Secure-Embedded-Systems/capri1_ets/CAPRI1_verifyPIN0.pdf

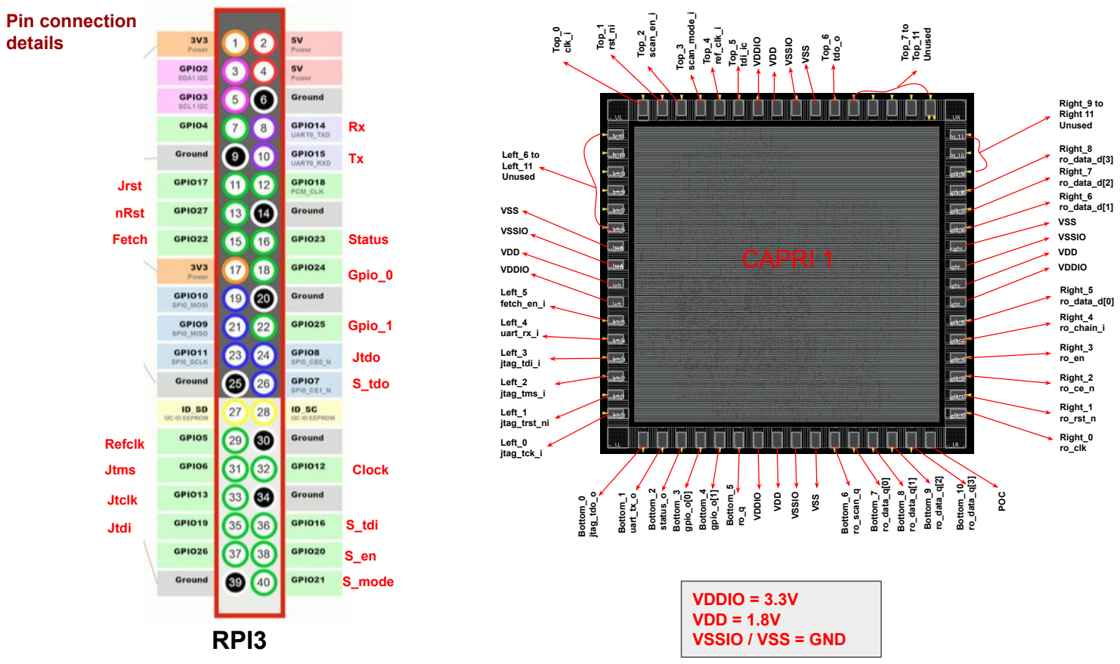
[picture p9: page 1]
RPI3; Bottom_10; ro_data_q[3]; VSS; VSSIO; VDD; VDDIO; Bottom_5; Bottom_2; status_o; Bottom_3; gpio_o[0]; Bottom_4; gpio_o[1]; Bottom_1; uart_tx_o; Bottom_0; jtag_tdo_o; POC; Bottom_8; Bottom_9; ro_data_q[2]; Bottom_6; Bottom_7; ro_data_q[0]; ro_data_q[1]; ro_scan_q; Left_0 jtag_tck_i; Left_1 jtag_trst_ni; Left_2 jtag_tms_i; Left_3 jtag_tdi_i; Left_4 uart_rx_i; Left_5 fetch_en_i; Left_6 to Left_11 Unused; Right_0 ro_clk; Right_1 ro_rst_n; Right_2 ro_ce_n; Right_3 ro_en; Right_4 ro_chain_i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

Refclk

Clock

Jtclk

S_tdi

Jtdi

VDDIO = 3.3V
VDD = 1.8V
VSSIO / VSS = GND

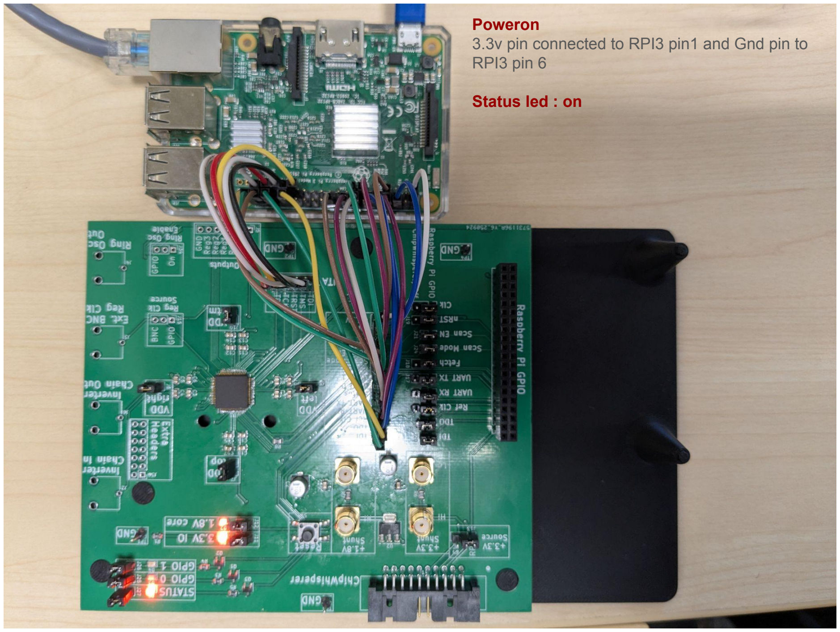
[picture p10: page 2]

Poweron
3.3v pin connected to RPI3 pin1 and Gnd pin to RPI3 pin 6

Status led : on

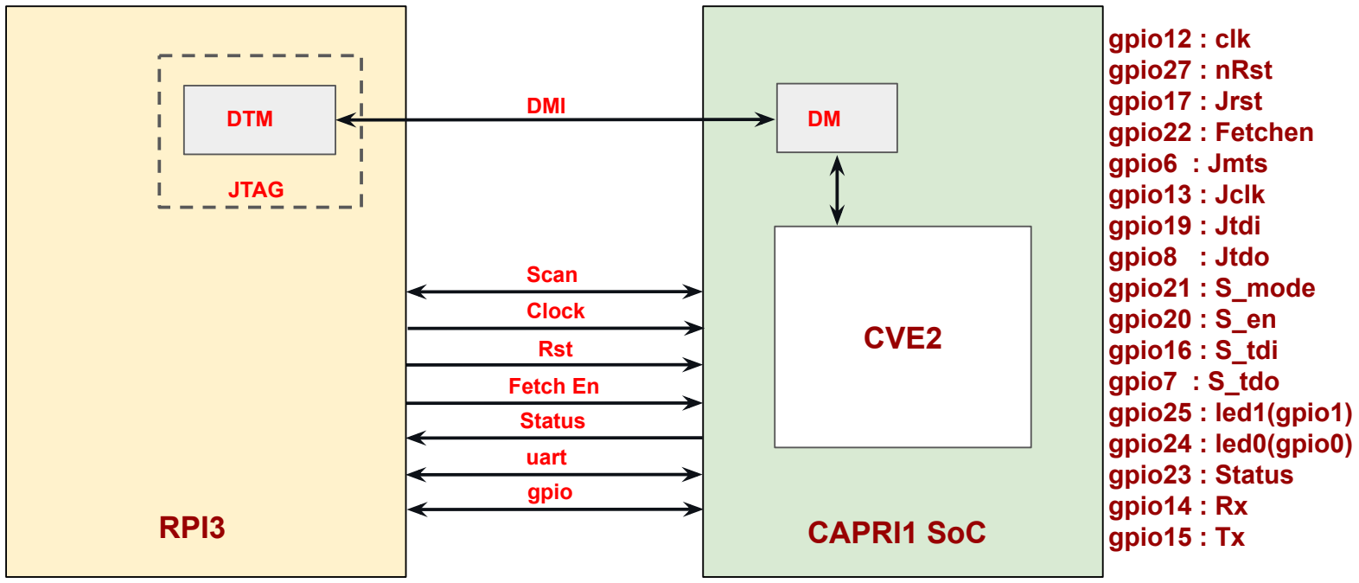
[picture p11: figure]
DTM; DM DMI; JTAG; CVE2; RPI3; CAPRI1 SoC; Scan; Clock; Rst; Fetch En; Status; uart; gpio; gpio12 : clk gpio27 : nRst gpio17 : Jrst gpio22 : Fetchen gpio6 : Jmts gpio13 : Jclk gpio19 : Jtdi gpio8 : Jtdo gpio21 : S_mode gpio20 : S_en gpio16 : S_tdi gpio7 : S_tdo gpio25 : led1(gpio1) gpio24 : led0(gpio0) gpio23 : Status gpio14 : Rx gpio15 : Tx

# Configuration 1. ./prep_pins.sh

2. openocd -f rpi3_gpio.cfg -f capri1_target.cfg; init; reset halt;

# 3. reset.tcl(when DM halt hart fails to responded) Capture : map and group 4. scan_chain_capture_10cc.py 5. map_and_group_script.py

pschaumont@raspberrypi:~/capri1/scripts/9oct/test/v1 $ ./prep_pins.sh [prep] ensure pigpiod is running
GPIO 12: level=1 fsel=4 alt=0 func=PWM0
[prep] status:
GPIO17: GPIO 17: level=1 fsel=1 func=OUTPUT GPIO27: GPIO 27: level=1 fsel=1 func=OUTPUT GPIO12: GPIO 12: level=1 fsel=4 alt=0 func=PWM0 GPIO22: GPIO 22: level=0 fsel=1 func=OUTPUT GPIO6 : GPIO 6: level=1 fsel=1 func=OUTPUT GPIO13: GPIO 13: level=0 fsel=1 func=OUTPUT GPIO19: GPIO 19: level=0 fsel=1 func=OUTPUT GPIO8 : GPIO 8: level=0 fsel=0 func=INPUT GPIO21: GPIO 21: level=0 fsel=1 func=OUTPUT GPIO20: GPIO 20: level=0 fsel=1 func=OUTPUT GPIO16: GPIO 16: level=0 fsel=1 func=OUTPUT GPIO7 : GPIO 7: level=0 fsel=0 func=INPUT GPIO25: GPIO 25: level=0 fsel=0 func=INPUT GPIO24: GPIO 24: level=0 fsel=0 func=INPUT GPIO23: GPIO 23: level=1 fsel=0 func=INPUT
GPIO14: GPIO 14: level=0 fsel=1 func=OUTPUT
GPIO15: GPIO 15: level=1 fsel=0 func=INPUT
[prep] Clock is now on GPIO12 (PWM0). Wire CAPRI1 clk_i to GPIO12.

## ./prep_pins.sh

# Configuration : GPIO pins on RPI3

pschaumont@raspberrypi:~/capri1/scripts/9oct/test/v1 $ openocd -f rpi3_gpio.cfg -f capri1_target.cfg Open On-Chip Debugger 0.12.0
Licensed under GNU GPL v2
For bug reports, read
http://openocd.org/doc/doxygen/bugs.html adapter speed: 100 kHz

Warn : Transport "jtag" was already selected
0
Info : Listening on port 6666 for tcl connections Info : Listening on port 4444 for telnet connections
Info : BCM2835 GPIO JTAG/SWD bitbang driver
Info : clock speed 100 kHz
Info : JTAG tap: capri1.cpu tap/device found: 0x0c0c5db3 (mfg: 0x6d9 (PULP Platform), part: 0xc0c5, ver: 0x0) Info : datacount=2 progbufsize=8
Info : Examined RISC-V core; found 1 harts
Info : hart 0: XLEN=32, misa=0x40100104
Info : starting gdb server for capri1.cpu on 3333 Info : Listening on port 3333 for gdb connections

## openocd -f rpi3_gpio.cfg -f capri1_target.cfg

# Configuration : openocd

init
riscv dmi_write 0x10 0x00000001 | ;# dmactive=1
riscv dmi_write 0x38 0x20040C07 | ;# SBA: 32-bit, autoinc, read-on-data
riscv dmi_write 0x37 0x00000000
riscv dmi_write 0x39 0x03000004 | ;# FETCHEN
riscv dmi_write 0x3C 0x00000001 | ;# FETCHEN=1
riscv dmi_write 0x10 0x04000003 | ;# setresethaltreq|ndmreset|dmactive
sleep 20
riscv dmi_write 0x10 0x04000001 ;# release reset (resethaltreq still set) sleep 20
riscv dmi_write 0x10 0x02000001 ;# clrresethaltreq
riscv dmi_read 0x11

# Reset

### reset.tcl (when DM halt hart fails to responded)

mww 0x10000000 0x0 256
mdw 0x10000000 256

halt
load_image /home/pschaumont/capri1/scripts/9oct/test/v1/verifyPIN_0/verifyPIN_0_opt.bin 0x10000000 bin
shutdown

# Load_image

## scan_chain_capture_10cc.py (capture 10cc scan chain values) map_and_group_script.py (map and group bits)

# Capture : scan chain values

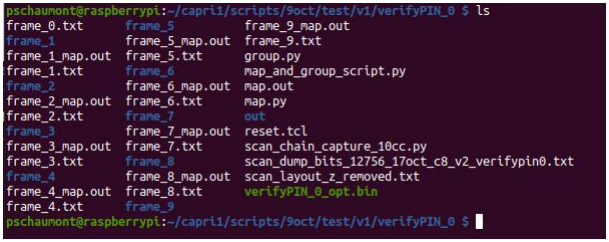
[picture p12: figure]

## verifyPIN_0

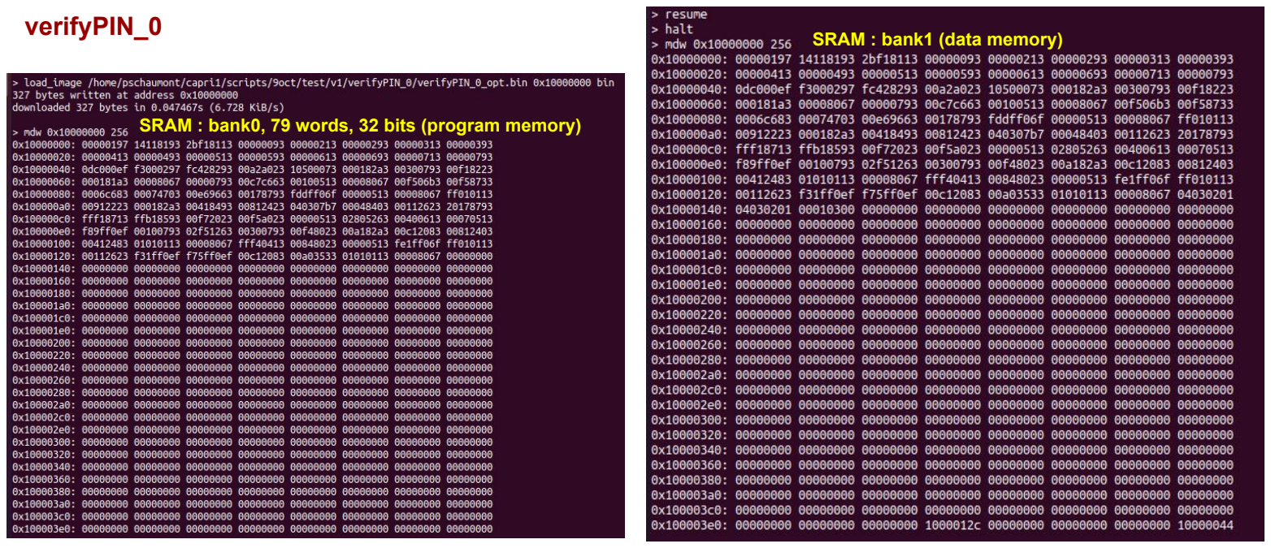
[picture p13: page 9]

SRAM : bank0, 79 words, 32 bits (program memory)

SRAM : bank1 (data memory)

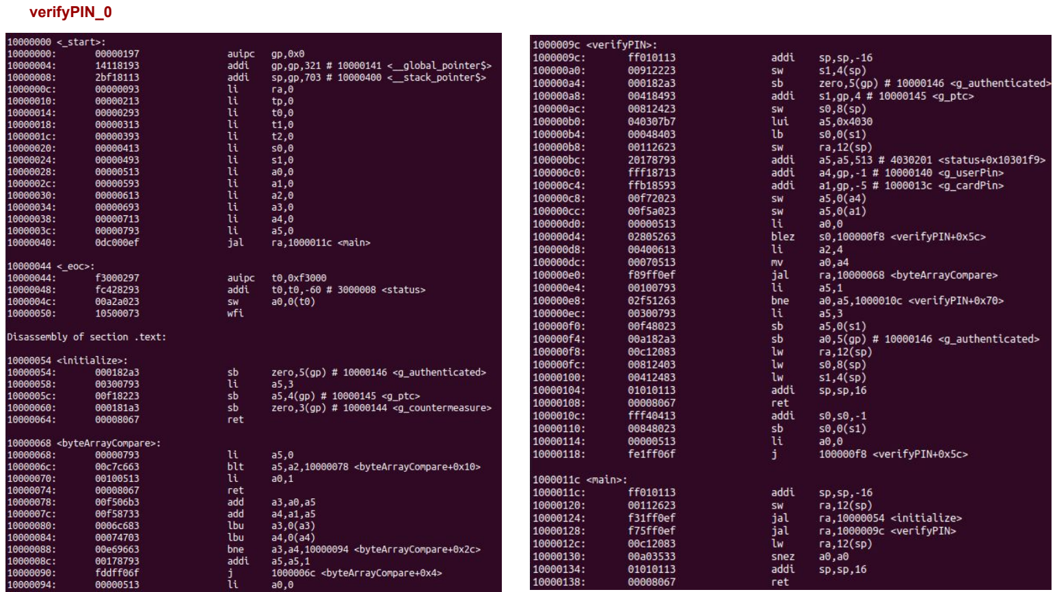
[picture p14: page 10]

verifyPIN_0
