Secure-Embedded-Systems/capri1_ets/rtl/riscv-dbg/tb/jtag_test_simple.sv

// Copyright 2020 ETH Zurich and University of Bologna.
// Solderpad Hardware License, Version 0.51, see LICENSE for details.
// SPDX-License-Identifier: SHL-0.51

// Author: Andreas Traber <atraber@iis.ee.ethz.ch>
// Author: Florian Zaruba <zarubaf@iis.ee.ethz.ch>
// Author: Fabian Schuiki <fschuiki@iis.ee.ethz.ch>
// Author: Thomas Benz <tbenz@iis.ee.ethz.ch>
timeunit 1ns;
timeprecision 1ps;


module jtag_driver_simple #(
  parameter int IrLength = 0,
  parameter IDCODE       = 'h1,
  parameter time TA      = 0ns,  // stimuli application time
  parameter time TT      = 0ns   // stimuli test time
) (
  input  logic jtag_tck_i,
  output logic jtag_trst_no,
  output logic jtag_tms_o,
  output logic jtag_tdi_o,
  input  logic jtag_tdo_i
);

  localparam DMIWidth = $bits(dm::dmi_req_t);

  // last IR register select
  logic [IrLength-1:0] ir_select = 'h1;

  task reset_master;
    #TA;
    jtag_tms_o   = 1;
    jtag_tdi_o   = 0;
    jtag_trst_no = 0;
    repeat (2) clock();
    #TA;
    jtag_trst_no  = 1;
    ir_select = 'h1;
    clock();
  endtask

  task soft_reset();
    #TA;
    jtag_tms_o = 1;
    jtag_tdi_o = 0;
    repeat (6) clock();
    #TA;
    jtag_tms_o = 0;
    clock();
    // After softreset the IR should be reset to IDCODE so we have to mirror
    // this in our internal state.
    ir_select = 'h1;
  endtask

  // Set IR, but only if it needs to be set.
  task set_ir(input logic [IrLength-1:0] opcode);
    logic opcode_unpacked [IrLength];
    // check whether IR is already set to the right value
    if (ir_select == opcode) return;
    // {<<{opcode_unpacked}} = opcode;
    for (int i = 0; i < IrLength; i++) begin
        opcode_unpacked[i] = opcode[i];
    end
    write_tms(1); // select DR scan
    write_tms(1); // select IR scan
    write_tms(0); // capture IR
    write_tms(0); // shift IR
    write_bits_opcode(opcode_unpacked, 1);
    write_tms(1); // update IR
    write_tms(0); // run test idle
    ir_select = opcode;
  endtask
  // Go from `run_test_idle` to `shift_dr`
  task shift_dr();
    write_tms(1); // select DR scan
    write_tms(0); // capture DR
    write_tms(0); // shift DR
  endtask

  // Go to `run_test_idle`
  task update_dr(bit exit_1_dr);
    // depending on the state `exit_1_dr` is already reached when shifting data (`tms_on_last`).
    if (exit_1_dr) write_tms(1); // exi 1 DR
    write_tms(1); // update DR
    write_tms(0); // run test idle
  endtask

  task write_bits_opcode(input logic wdata [IrLength], input logic tms_last);
    for (int i = 0; i < IrLength; i++) begin
      #TA;
      jtag_tdi_o = wdata[i];
      if (i == (IrLength - 1)) jtag_tms_o = tms_last;
      clock();
    end
  endtask

  task write_bits_32(input logic wdata [32], input logic tms_last);
    for (int i = 0; i < 32; i++) begin
      #TA;
      jtag_tdi_o = wdata[i];
      if (i == 31) jtag_tms_o = tms_last;
      clock();
    end
  endtask

  task write_bits_dmi(input logic wdata [DMIWidth], input logic tms_last);
    for (int i = 0; i < DMIWidth; i++) begin
      #TA;
      jtag_tdi_o = wdata[i];
      if (i == (DMIWidth - 1)) jtag_tms_o = tms_last;
      clock();
    end
  endtask

  // Assumes JTAG FSM is already in shift DR state
  task readwrite_bits_32(output logic rdata [32], input logic wdata [32], input logic tms_last);
    for (int i = 0; i < 32; i++) begin
      #TA;
      jtag_tdi_o = wdata[i];
      if (i == 31) jtag_tms_o = tms_last; // tms_last ? exit1 DR : shift DR
      cycle_start();
      rdata[i] = jtag_tdo_i;
      cycle_end();
    end
  endtask

  // Assumes JTAG FSM is already in shift DR state
  task readwrite_bits_dmi(output logic rdata [DMIWidth], input logic wdata [DMIWidth], input logic tms_last);
    for (int i = 0; i < DMIWidth; i++) begin
      #TA;
      jtag_tdi_o = wdata[i];
      if (i == (DMIWidth - 1)) jtag_tms_o = tms_last; // tms_last ? exit1 DR : shift DR
      cycle_start();
      rdata[i] = jtag_tdo_i;
      cycle_end();
    end
  endtask

  task wait_idle(int cycles);
    repeat(cycles) clock();
  endtask

  task write_tms(input logic tms_val);
    #TA;
    jtag_tms_o = tms_val;
    cycle_end();
  endtask

  task clock();
    cycle_start(); cycle_end();
  endtask

  task cycle_start;
    #(TT - TA);
  endtask

  task cycle_end;
    @(posedge jtag_tck_i);
  endtask
endmodule


// abstracts the debug module
module riscv_dbg_simple #(
  parameter int IrLength = 5,
  parameter IDCODE    = 'h1,
  parameter DTMCSR    = 'h10,
  parameter DMIACCESS = 'h11,
  parameter time TA = 0ns, // stimuli application time
  parameter time TT = 0ns  // stimuli test time
) (
  input  logic jtag_tck_i,
  output logic jtag_trst_no,
  output logic jtag_tms_o,
  output logic jtag_tdi_o,
  input  logic jtag_tdo_i
);

  localparam DMIWidth = $bits(dm::dmi_req_t);

  jtag_driver_simple #(
    .IrLength ( IrLength ),
    .TA       ( TA       ),
    .TT       ( TT       )
  ) jtag (
    .jtag_tck_i,
    .jtag_trst_no,
    .jtag_tms_o,
    .jtag_tdi_o,
    .jtag_tdo_i
  );

  task reset_master();
    jtag.reset_master();
    jtag.soft_reset();
  endtask

  task wait_idle(int cycles);
    jtag.wait_idle(cycles);
  endtask

  task get_idcode(output logic [31:0] idcode);
    logic read_data [32], write_data [32];
    write_data = '{default: 1'b0};
    jtag.set_ir(IDCODE);
    jtag.shift_dr();
    jtag.readwrite_bits_32(read_data, write_data, 1'b0);
    jtag.update_dr(1'b1);
    // idcode = {<<{read_data}};
    for (int i = 0; i < 32; i++) begin
        idcode[i] = read_data[i];
    end
  endtask

  task write_dtmcs(input logic [31:0] data);
    logic write_data [32];
    logic [31:0] write_data_packed;
    write_data_packed = {data};
    // {<<{write_data}} = write_data_packed;
    for (int i = 0; i < 32; i++) begin
        write_data[i] = write_data_packed[i];
    end
    jtag.set_ir(DTMCSR);
    jtag.shift_dr();
    jtag.write_bits_32(write_data, 1'b1);
    jtag.update_dr(1'b0);
  endtask

  task read_dtmcs(output dm::dtmcs_t data, input int wait_cycles = 10);
    logic read_data [32], write_data [32];
    jtag.set_ir(DTMCSR);
    jtag.shift_dr();
    // shift out read data
    // {<<{write_data}} = 32'b0;
    for (int i = 0; i < 32; i++) begin
        write_data[i] = '0;
    end
    jtag.readwrite_bits_32(read_data, write_data, 1'b1);
    jtag.update_dr(1'b0);
    // data = dm::dtmcs_t'({<<{read_data}});
    for (int i = 0; i < 32; i++) begin
        data[i] = dm::dtmcs_t'(read_data[i]);
    end
  endtask

  task reset_dmi();
    logic [31:0] dmireset;
    dmireset = 1 << 16;
    write_dtmcs(dmireset);
  endtask

  task write_dmi(input dm::dm_csr_e address, input logic [31:0] data);
    logic write_data [DMIWidth];
    logic [DMIWidth-1:0] write_data_packed;
    write_data_packed = {address, data, dm::DTM_WRITE};
    // {<<{write_data}} = write_data_packed;
    for (int i = 0; i < DMIWidth; i++) begin
        write_data[i] = write_data_packed[i];
    end
    jtag.set_ir(DMIACCESS);
    jtag.shift_dr();
    jtag.write_bits_dmi(write_data, 1'b1);
    jtag.update_dr(1'b0);
  endtask

  task read_dmi(input dm::dm_csr_e address, output logic [31:0] data, input int wait_cycles = 10,
                output dm::dtm_op_status_e op);
    logic read_data [DMIWidth], write_data [DMIWidth];
    automatic logic [DMIWidth-1:0] data_out = 0;
    automatic logic [DMIWidth-1:0] write_data_packed = {address, 32'b0, dm::DTM_READ};
    // {<<{write_data}} = write_data_packed;
    for (int i = 0; i < DMIWidth; i++) begin
        write_data[i] = write_data_packed[i];
    end
    jtag.set_ir(DMIACCESS);
    // send read command
    jtag.shift_dr();
    jtag.write_bits_dmi(write_data, 1'b1);
    jtag.update_dr(1'b0);
    jtag.wait_idle(wait_cycles);
    // shift out read data
    jtag.shift_dr();
    write_data_packed = {address, 32'b0, dm::DTM_NOP};
    // {<<{write_data}} = write_data_packed;
    for (int i = 0; i < DMIWidth; i++) begin
        write_data[i] = write_data_packed[i];
    end
    jtag.readwrite_bits_dmi(read_data, write_data, 1'b1);
    jtag.update_dr(1'b0);
    // data_out = {<<{read_data}};
    for (int i = 0; i < DMIWidth; i++) begin
        data_out[i] = read_data[i];
    end
    op = dm::dtm_op_status_e'(data_out[1:0]);
    data = data_out[33:2];
  endtask

  // Repeatedly read DMI until we get a valid response.
  // The delay between Update-DR and Capture-DR of
  // successive operations is automatically adjusted through
  // an exponential backoff scheme.
  // Note: read operations which have side-effects (e.g.
  // reading SBData0) should not use this function
  task read_dmi_exp_backoff(input dm::dm_csr_e address, output logic [31:0] data);
    logic read_data [DMIWidth], write_data [DMIWidth];
    logic [DMIWidth-1:0] write_data_packed;
    automatic logic [DMIWidth-1:0] data_out = 0;
    automatic dm::dtm_op_status_e op = dm::DTM_SUCCESS;
    automatic int trial_idx = 0;
    automatic int wait_cycles = 8;

    do begin
      if (trial_idx != 0) begin
        // Not entered upon first iteration, resets the
        // sticky error state if previous read was unsuccessful
        reset_dmi();
      end
      read_dmi(address, data, wait_cycles, op);
      wait_cycles *= 2;
      trial_idx++;
    end while (op == dm::DTM_BUSY);
  endtask

  task sba_read_double(input logic [31:0] address, output logic [63:0] data);
    // Attempt the access sequence. Two timing violations may
    // occur:
    // 1) an operation is attempted while a DMI request is still
    //    in progress;
    // 2) a SB read is attempted while a read is still in progress
    //    or a SB access is attempted while one is in progress
    // In either case the whole sequence must be re-attempted with
    // increased delays.
    // Case 1) is intercepted when the op returned by a read is == DTM_BUSY,
    // the sequence can be interrupted early and the delay to be adjusted is
    // that between the update phase and the capture phase of a successive op.
    // Case 2) is intercepted at the end of the sequence by reading the
    // SBCS register, and checking sbbusyerror. In this case the delay to be
    // adjusted is that before the SBData read operations.
    dm::dtm_op_status_e op;
    automatic int dmi_wait_cycles = 2;
    automatic int sba_wait_cycles = 2;
    automatic dm::sbcs_t sbcs = '{sbreadonaddr: 1, sbaccess: 3, default: '0};
    dm::sbcs_t read_sbcs;
    // Check address is 64b aligned
    assert (address[2:0] == '0) else $error("[JTAG] 64b-unaligned accesses not supported");
    // Start SBA sequence attempts
    while (1) begin
      automatic bit failed = 0;
      write_dmi(dm::SBCS, sbcs);
      write_dmi(dm::SBAddress0, address);
      wait_idle(sba_wait_cycles);
      read_dmi(dm::SBData1, data[63:32], dmi_wait_cycles, op);
      // Skip second read if we already have a DTM busy error
      // else we can override op
      if (op != dm::DTM_BUSY) begin
        read_dmi(dm::SBData0, data[31:0], dmi_wait_cycles, op);
      end
      // If we had a DTM_BUSY error, increase dmi_wait_cycles and clear error
      if (op == dm::DTM_BUSY) begin
        dmi_wait_cycles *= 2;
        failed = 1'b1;
        reset_dmi();
      end
      // Test sbbusyerror and wait for sbbusy == 0
      // Error is cleared in next iteration when writing SBCS
      do begin
        sbcs.sbbusyerror = 1'b0;
        read_dmi_exp_backoff(dm::SBCS, read_sbcs);
        if (read_sbcs.sbbusyerror) begin
          sbcs.sbbusyerror = 1'b1; // set 1 to clear
          sba_wait_cycles *= 2;
          failed = 1'b1;
        end
        if (read_sbcs.sbbusy) wait_idle(sba_wait_cycles);
      end while (read_sbcs.sbbusy);
      // Exit loop if sequence was successful
      if (!failed) break;
    end
  endtask

endmodule
